mnimonic/esp32-tpms/(commit log)

2026-11-03 Repo cleanup: neutral default logo, local custom logo, no personal path
    - logo.h is now a neutral TPMS warning symbol (tools/make_default_logo.py)
    - the sketch uses a local, git-ignored logo_custom.h when present
    - trademarked logo image and logo_custom.h are no longer tracked
    - generic arduino-cli path in CLAUDE.md
    Claude-Session: https://claude.ai/code/session_01Vzk9vZbSfYSiLF9FbkqjYC
    [ESP-TPMS.ino]
2026-11-03 Split the sketch into tabs (no functional change)
    ESP-TPMS.ino keeps includes, settings, types and globals; the code is
    in numbered tabs (10_ble ... 99_setup_loop) so Arduino compiles them in
    the original order. Same binary size as the single-file version.
    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
2026-11-03 Add buzzer support (v0.0.22)
    Optional buzzer on GPIO 0 (active, passive or active-low module):
    2 short beeps for LOW / HIGH, 3 long beeps for DROPPING / HOT,
    repeated every 60 s while the alert number blinks; non-blocking
    patterns; menu item Buzzer (Off / Alerts / Alerts+click) with a test
    beep; short chirp at start-up.
    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
    [20_storage.ino, 35_buzzer.ino, 50_menu.ino, 70_display.ino, 99_setup_loop.ino, ESP-TPMS.ino]
2026-11-03 Add WiFi settings page (v0.1.0)
    - Menu -> WiFi setup starts a hotspot (ESP-TPMS / tpms1234) with a
    settings page at http://192.168.4.1: live readings, every setting,
    reset pairing and factory reset; click or 10 min idle stops WiFi
    - password can be overridden in a git-ignored secrets.h
    - partition scheme Minimal SPIFFS (1.9 MB app) is now required;
    CI and docs updated
    - debug builds accept serial commands wifi / wifioff
    - README: WiFi, buzzer wiring/sounds, code structure; CHANGELOG,
    TODO and CLAUDE.md updated
    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
    [50_menu.ino, 70_display.ino, 80_screen.ino, 85_wifi.ino, 99_setup_loop.ino, ESP-TPMS.ino]
2026-11-05 Add SD card ride log (v0.1.1)
    CSV per ignition-on in /logs/rideNNNN.csv on the TFT module's SD slot
    (MISO GPIO 20, CS GPIO 21, SCK/MOSI shared), downloadable from the WiFi page.
    Claude-Session: https://claude.ai/code/session_01Vzk9vaWmAkqFZmSHWFBJae
2026-11-08 Keep last reading across power cycles, stay on until sensors wake, WiFi join fix (v0.1.6)
    Claude-Session: https://claude.ai/code/session_01Vzk9vbcZwfqxLw7z1G7DvU
    [10_ble.ino, 20_storage.ino, 40_pairing.ino, 60_readings.ino, 70_display.ino, 80_screen.ino, 85_wifi.ino, ESP-TPMS.ino]
